petl/mrna_vaccine_badge/documents/photos_sorted/IMG_20210912_192453.jpg

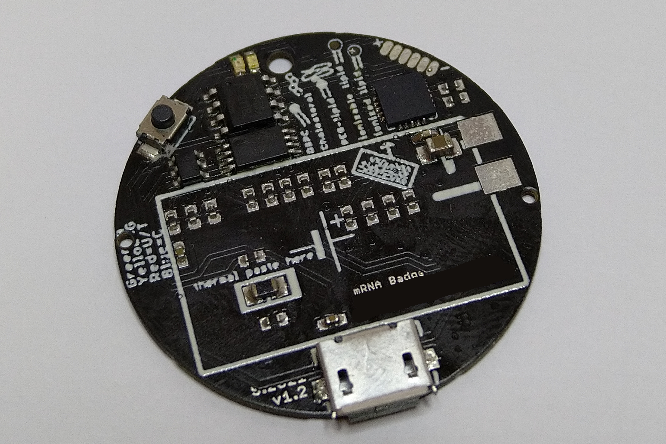
documents/photos_sorted/IMG_20210912_192453.jpg
