petl/mrna_vaccine_badge/documents/photos_sorted/IMG_20210912_192819.jpg

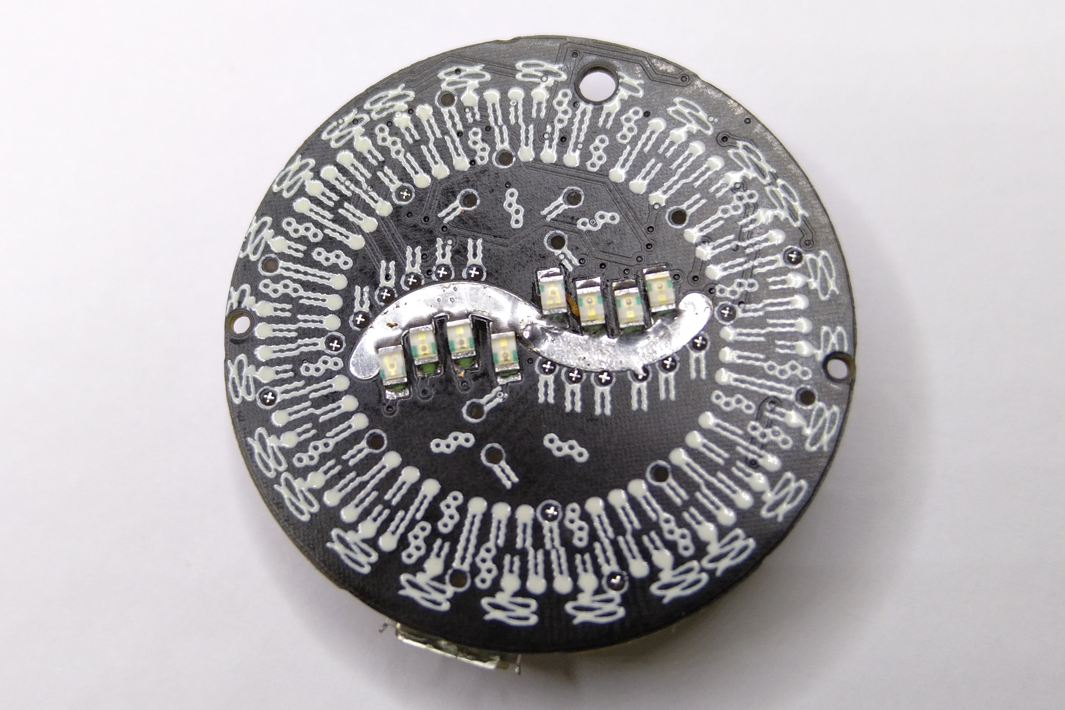
documents/photos_sorted/IMG_20210912_192819.jpg
