petl/mrna_vaccine_badge/documents/photos_sorted/IMG_20210912_193202.jpg

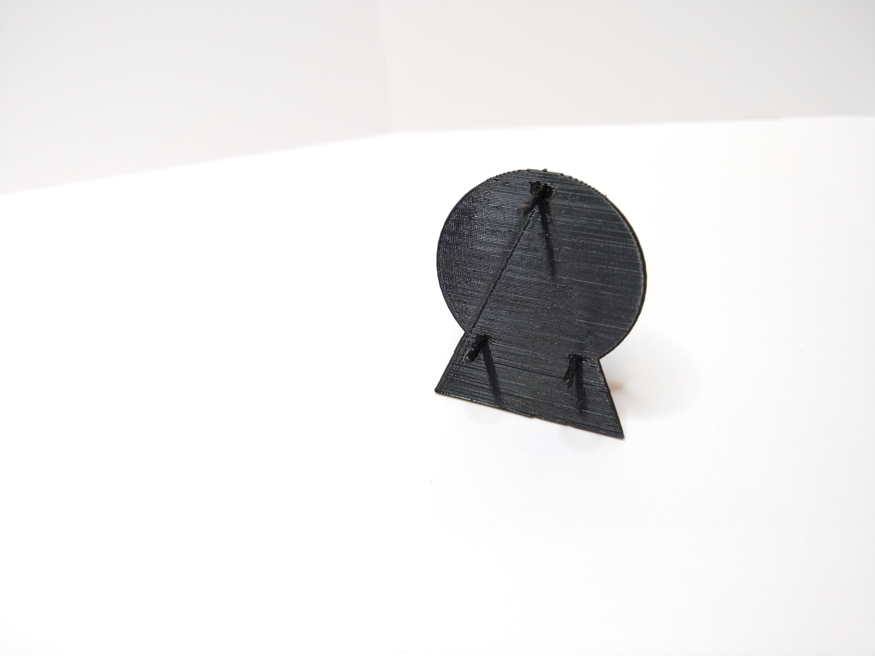
documents/photos_sorted/IMG_20210912_193202.jpg
