petl/mrna_vaccine_badge/documents/photos_sorted/IMG_20210912_193354_2.jpg

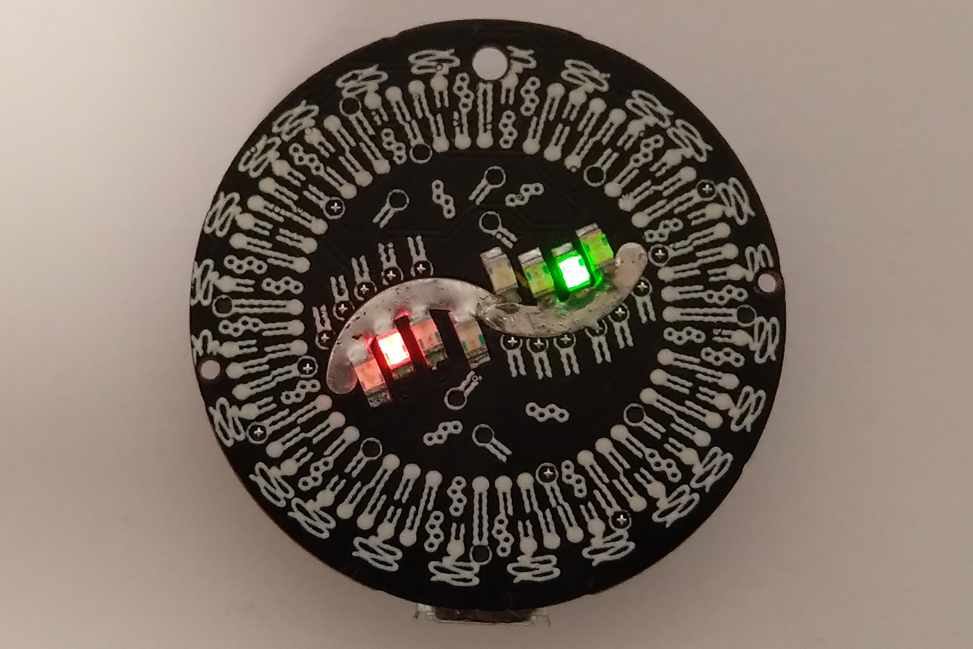
documents/photos_sorted/IMG_20210912_193354_2.jpg
