petl/mrna_vaccine_badge/documents/photos_sorted/IMG_20210912_215449.jpg

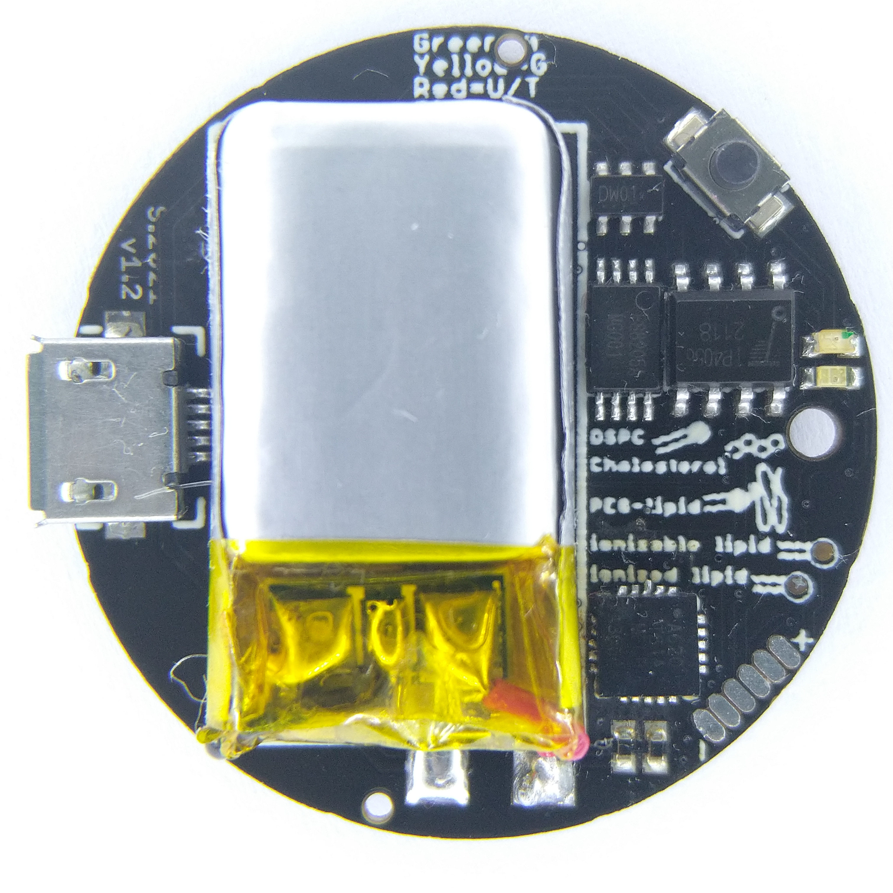
documents/photos_sorted/IMG_20210912_215449.jpg
