petl/mrna_vaccine_badge/documents/photos_sorted/IMG_20210912_224028.jpg

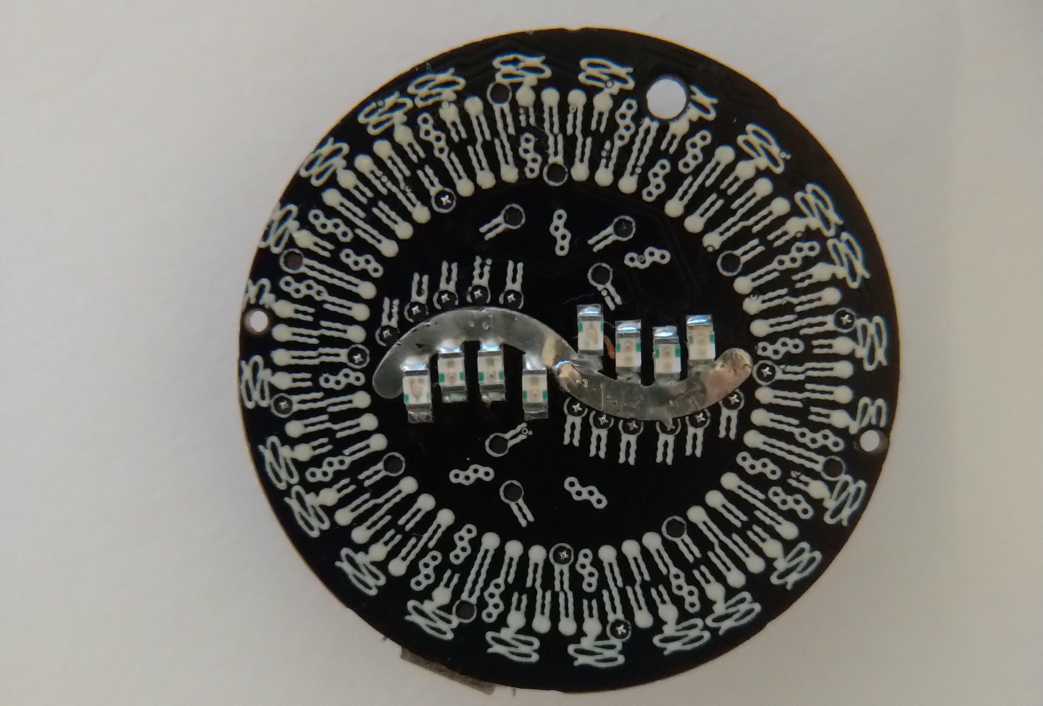
documents/photos_sorted/IMG_20210912_224028.jpg
