petl/mrna_vaccine_badge/documents/schematics_v1.3.png

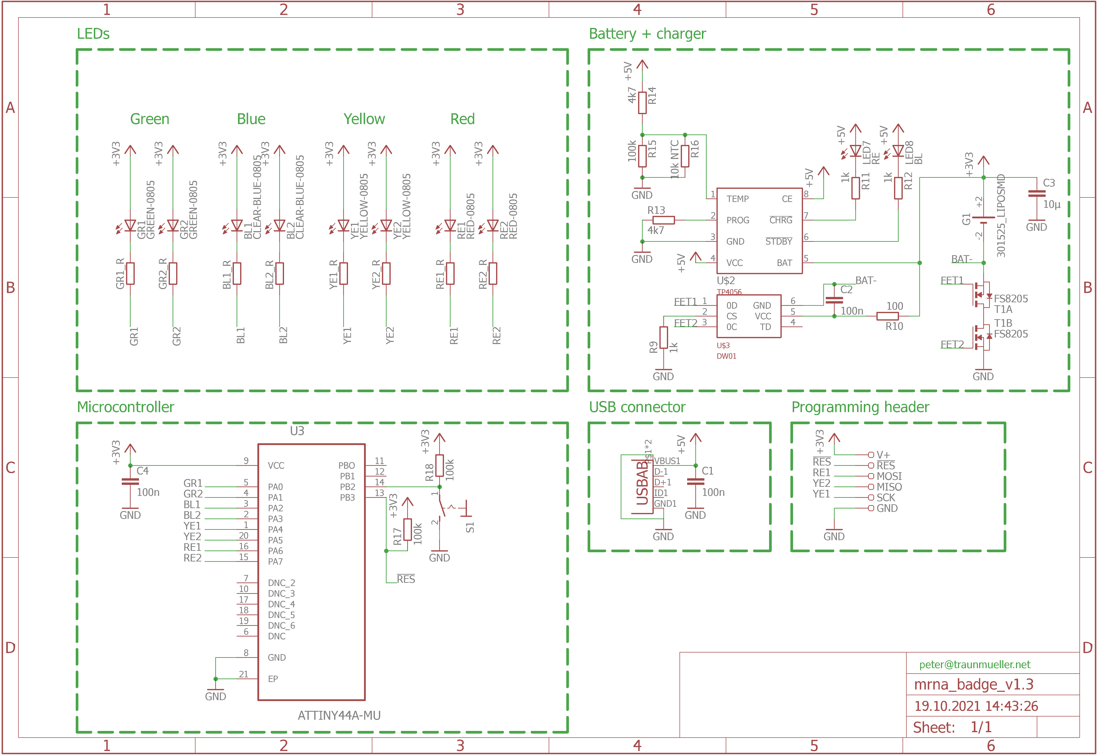
documents/schematics_v1.3.png
