petl/mrna_vaccine_badge/mechanics/tablestand_v1.2.SLDPRT

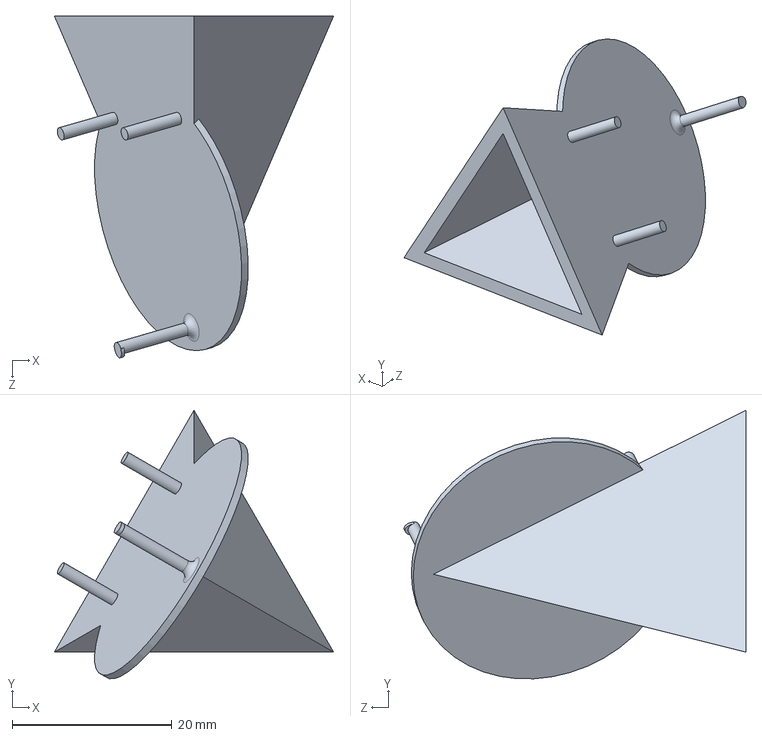
[picture p11: CAD file, 2021-08-27]
mechanics/tablestand_v1.2.SLDPRT
35.0 x 33.7 x 42.9 mm
