petl/mrna_vaccine_badge/(list of files, cad)

Other CAD files:
mechanics/tablestand_v1.2.STL
