petl/mrna_vaccine_badge/pcb/mrna_badge_v1.3.sch

## EAGLE design pcb/mrna_badge_v1.3.sch (2021-10-19)

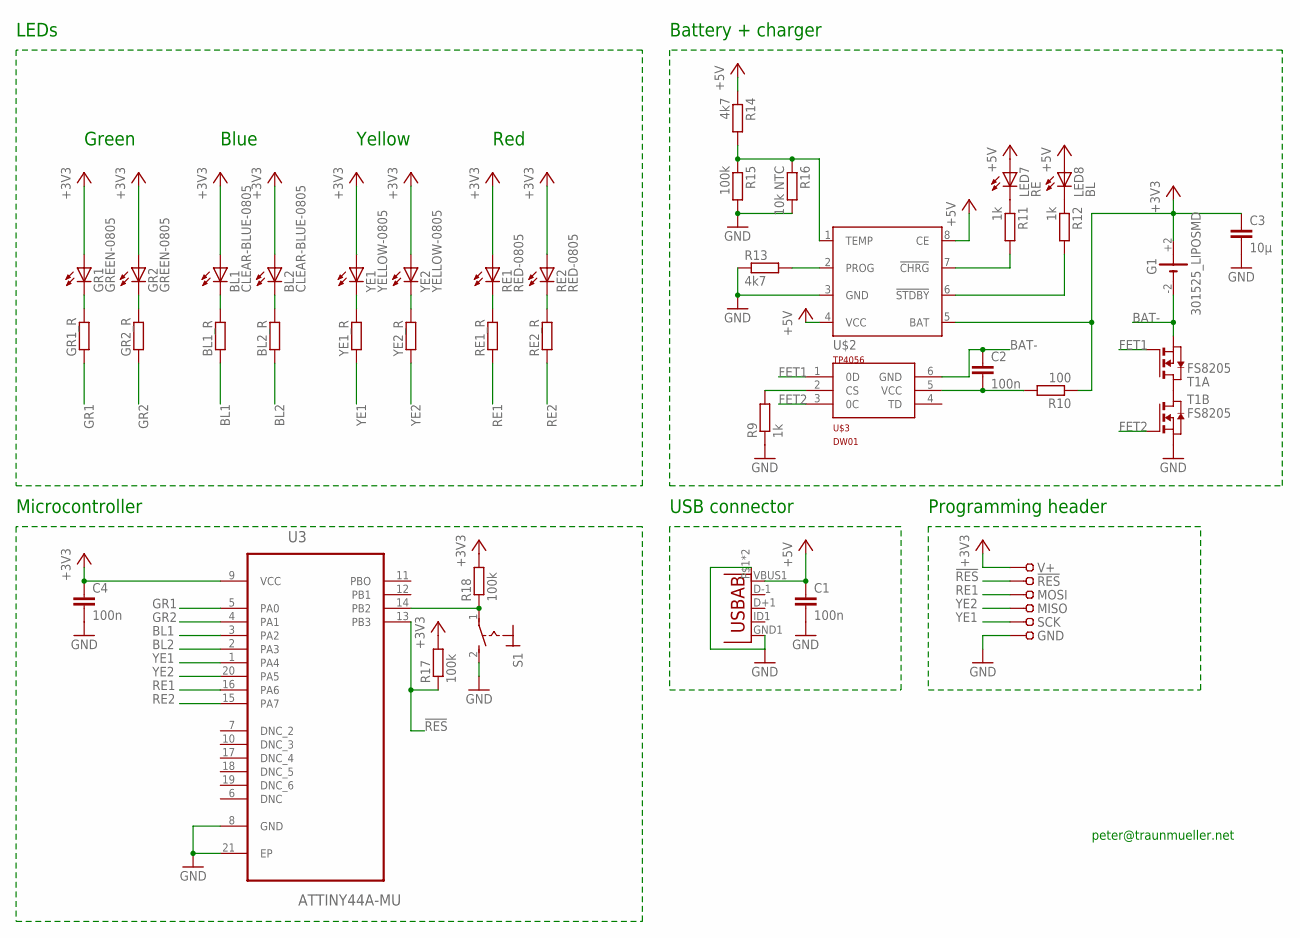
[picture p12: schematic mrna_badge_v1.3.sch]

Parts:
!RES: 0.7MM_POGO-PINSPADS; 0.7MM_SMD_PADS
BL1, BL2: CLEAR-BLUE-0805; CHIPLED_0805
BL1_R, BL2_R: R-EU_R0402; R0402
C1, C2, C4: 100n; C0402K
C3: 10µ; C0805K
G1: 301525_LIPOSMD; 301525_LIPO_SMDCONTACTS
GND: 0.7MM_POGO-PINSPADS; 0.7MM_SMD_PADS
GR1, GR2: GREEN-0805; CHIPLED_0805
GR1_R, GR2_R: R-EU_R0402; R0402
LED7: RE; CHIPLED_0603
LED8: BL; CHIPLED_0603
MISO: 0.7MM_POGO-PINSPADS; 0.7MM_SMD_PADS
MOSI: 0.7MM_POGO-PINSPADS; 0.7MM_SMD_PADS
R9, R11, R12: 1k; R0402
R10: 100; R0402
R13, R14: 4k7; R0402
R15, R17, R18: 100k; R0402
R16: 10k NTC; R0805
RE1, RE2: RED-0805; CHIPLED_0805
RE1_R, RE2_R: R-EU_R0402; R0402
S1: TS-1088NOHOLES; TS-1088_NOHOLES
SCK: 0.7MM_POGO-PINSPADS; 0.7MM_SMD_PADS
T1: FS8205; TSSOP-8
U2: USB""; USB-MICRO-SMD
U3: ATTINY44A-MU; QFN50P400X400X80-21N_FOOTPRINT
U$2: TP4056ESOP; ESOP23-8
U$3: DW01; SOT23-6
V+: 0.7MM_POGO-PINSPADS; 0.7MM_SMD_PADS
YE1, YE2: YELLOW-0805; CHIPLED_0805
YE1_R, YE2_R: R-EU_R0402; R0402

Connections:
3V3: BL1.A, BL2.A, C3.1, C4.1, G1.+2 (+), GR1.A, GR2.A, R10.1, R17.2, R18.2, RE1.A, RE2.A, U3.9 (VCC), U$2.5 (BAT), V+.P$1, YE1.A, YE2.A
!RES: !RES.P$1, R17.1, U3.13 (PB3)
+5V: C1.1, LED7.A, LED8.A, R14.1, U2.VBUS1 (VBUS), U$2.4 (VCC), U$2.8 (CE)
BAT-: C2.1, G1.-2 (-), T1.2 (S), U$3.6 (GND)
BL1: BL1_R.1, U3.3 (PA2)
BL2: BL2_R.1, U3.2 (PA3)
BUTTON: R18.1, S1.1, U3.14 (PB2)
FET1: T1.4 (G), U$3.1 (0D)
FET2: T1.5 (G), U$3.3 (0C)
GND: C1.2, C3.2, C4.2, GND.P$1, R9.1, R13.1, R15.2, R16.2, S1.2 (S), T1.6 (S), U2.GND1 (GND), U2.P$1 (CASE), U3.8 (GND), U3.21 (EP), U$2.3 (GND)
GR1: GR1_R.1, U3.5 (PA0)
GR2: GR2_R.1, U3.4 (PA1)
unnamed: GR1.C, GR1_R.2
unnamed: GR2.C, GR2_R.2
unnamed: BL1.C, BL1_R.2
unnamed: BL2.C, BL2_R.2
unnamed: YE1.C, YE1_R.2
unnamed: YE2.C, YE2_R.2
unnamed: RE1.C, RE1_R.2
unnamed: RE2.C, RE2_R.2
unnamed: T1.1 (D), T1.8 (D)
unnamed: R9.2, U$3.2 (CS)
unnamed: C2.2, R10.2, U$3.5 (VCC)
unnamed: R13.2, U$2.2 (PROG)
unnamed: LED7.C, R11.1
unnamed: LED8.C, R12.1
unnamed: R12.2, U$2.6 (!STDBY)
unnamed: R11.2, U$2.7 (!CHRG)
unnamed: R14.2, R15.1, R16.1, U$2.1 (TEMP)
RE1: MOSI.P$1, RE1_R.1, U3.16 (PA6)
RE2: RE2_R.1, U3.15 (PA7)
YE1: SCK.P$1, U3.1 (PA4), YE1_R.1
YE2: MISO.P$1, U3.20 (PA5), YE2_R.1

Notes on the sheet:
Battery + charger
USB connector
LEDs
Green
Blue
Yellow
Red
Programming header
Microcontroller
peter@traunmueller.net
