petl/mrna_vaccine_badge/(commit log)

2021-08-16 schematics v1.2 image
2021-08-16 pcb added LiPo circuit, changed footprints, changed µC to Attiny24/44/84
    [mrna_badge_v1.2.sch]
2021-08-16 routed v1.2
    [mrna_badge_v1.2.sch]
2021-08-16 Ignore Assembly stuff
2021-08-18 fixed routing issues for v1.2
    [mrna_badge_v1.2.sch]
2021-08-18 ported code for ATTiny24/44/84 and Arduino IDE
2021-08-18 updated schematics image
2021-08-27 half baked arduino version with both sequences. fits on a tiny44/84
2021-08-27 drew a mechanical stand for putting the PCB onto a desk
    [tablestand_v1.2.SLDPRT, tablestand_v1.2.STL]
2021-08-27 v1.3 kickoff
    [Patches_mrna_badge_v1.2.ods, mrna_badge_v1.3.sch]
2021-09-18 patches from v1.2 fixed for v1.3
    [Patches_mrna_badge_v1.2.ods, mrna_badge_v1.2.sch, mrna_badge_v1.3.sch]
2021-10-19 v1.3 schematic, added RES trace
    [mrna_badge_v1.3.sch]
